EinRainerZufall/ESPHomeCover/Purchase parts/17HS16-2004D_Torque_Curve.pdf

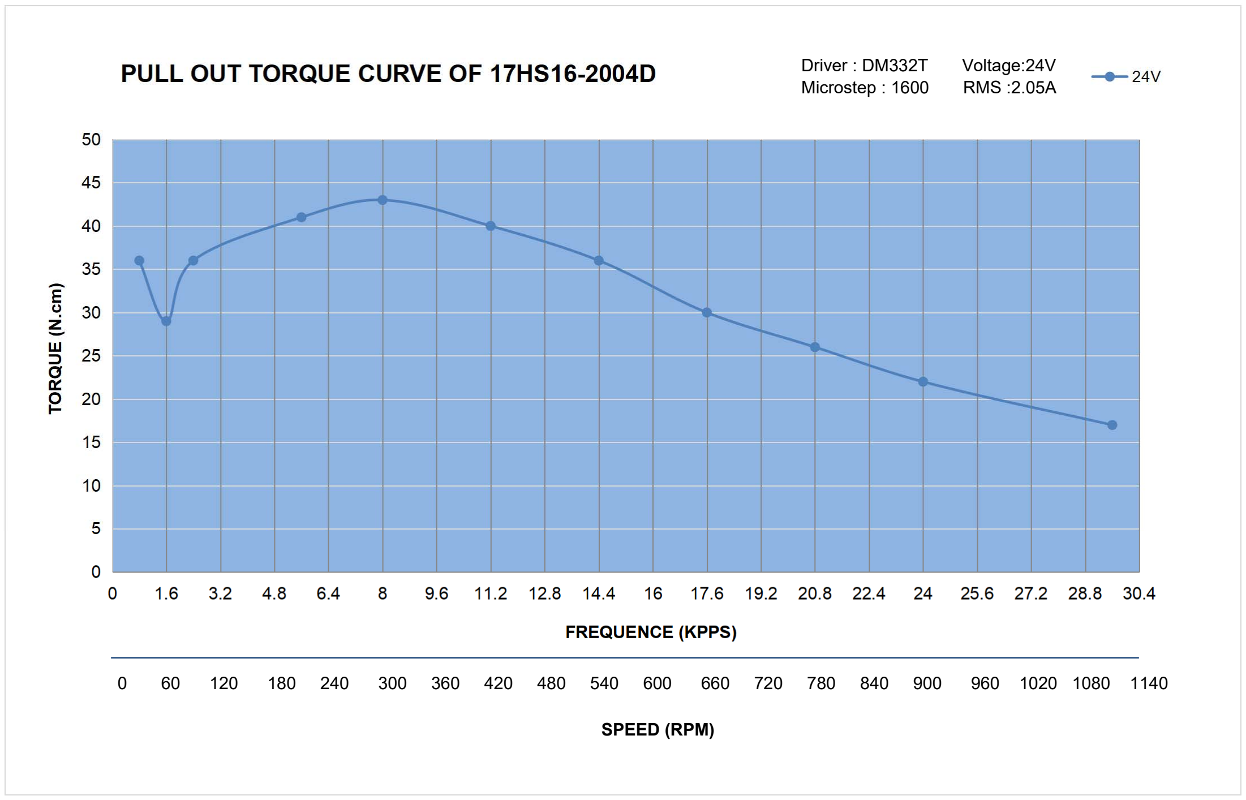
[picture p1: page 1]

Driver : DM332T | Voltage:24V
Microstep : 1600 | RMS :2.05A
0 | 60 | 120 | 180 | 240 | 300 | 360 | 420 | 480 | 540 | 600 | 660 | 720 | 780 | 840 | 900 | 960 1020 1080 1140

SPEED (RPM)
