EinRainerZufall/ESPHomeCover/3D print/complete set.3mf

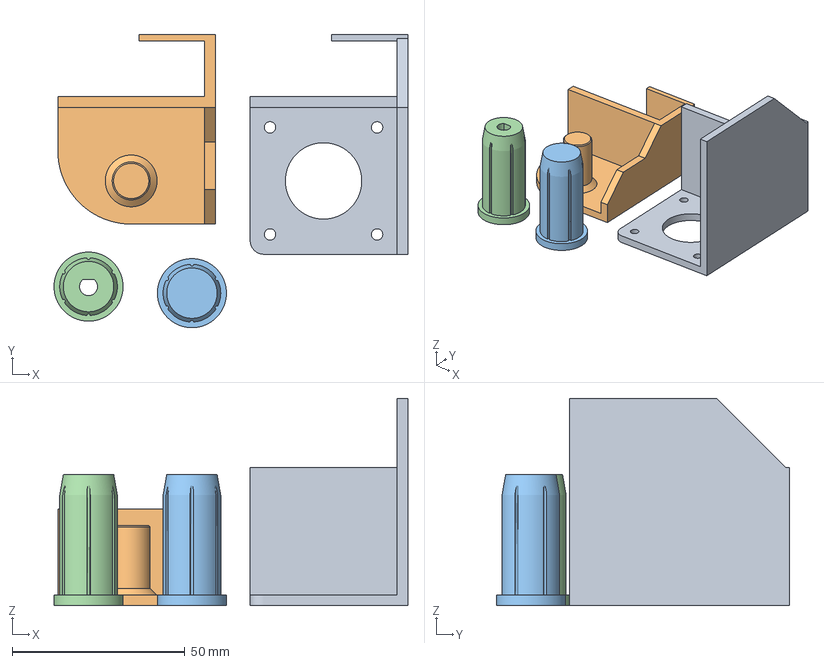
[picture p2: CAD file, 2024-05-02]
3D print/complete set.3mf
102.5 x 84.9 x 60.0 mm
motor holder.stp
counter holder.stp
blind adapter counter side.stp
blind adapter motor side.stp
