EinRainerZufall/ESPHomeCover/3D print/blind adapter counter side.stp

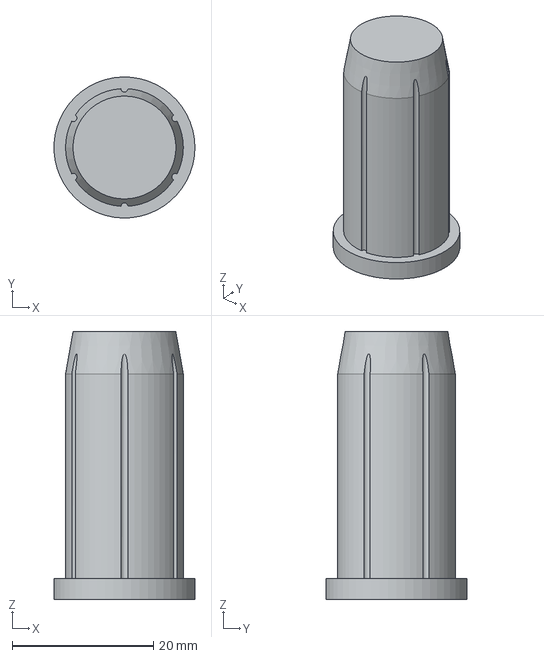
[picture p3: CAD file, 2024-05-02]
3D print/blind adapter counter side.stp
20.0 x 20.0 x 38.0 mm
