EinRainerZufall/ESPHomeCover/Purchase parts/17HS16-2004D.STEP

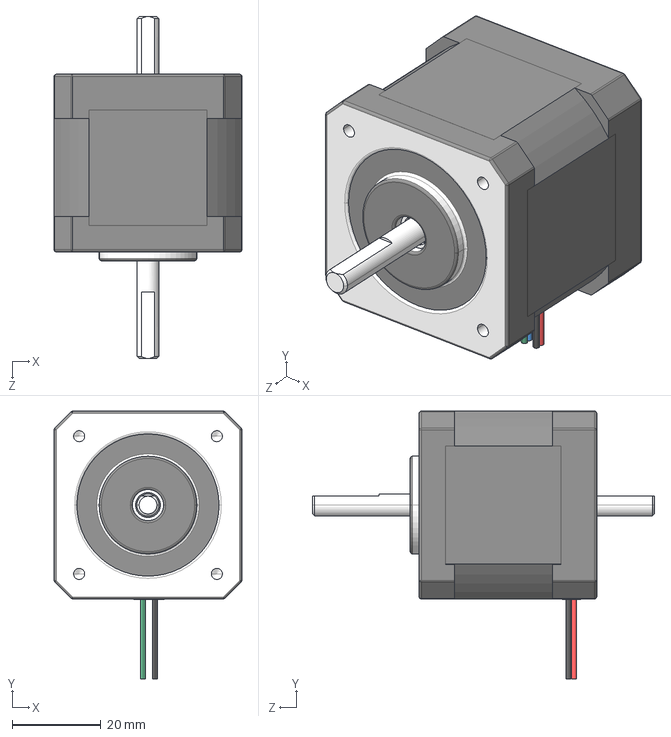
[picture p4: CAD file, 2024-03-02]
Purchase parts/17HS16-2004D.STEP
42.3 x 60.3 x 77.0 mm
