EinRainerZufall/ESPHomeCover/3D print/blind adapter motor side.stp

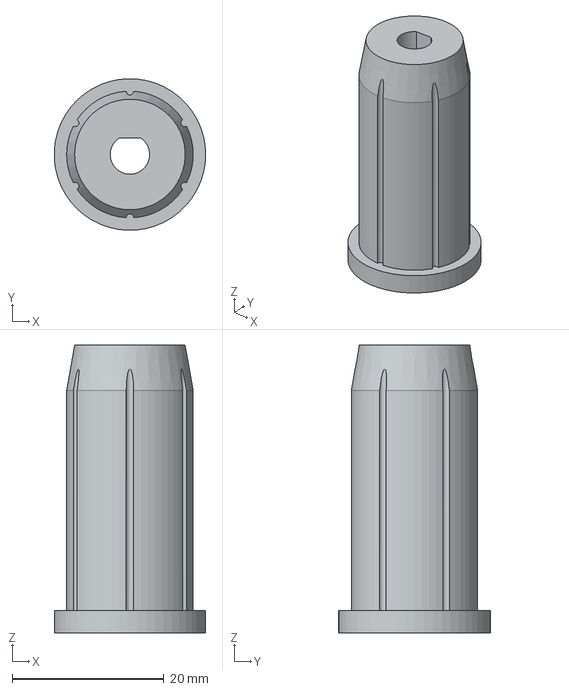
[picture p5: CAD file, 2024-05-02]
3D print/blind adapter motor side.stp
20.0 x 20.0 x 38.0 mm
