EinRainerZufall/ESPHomeCover/Purchase parts/SWB-01.STEP

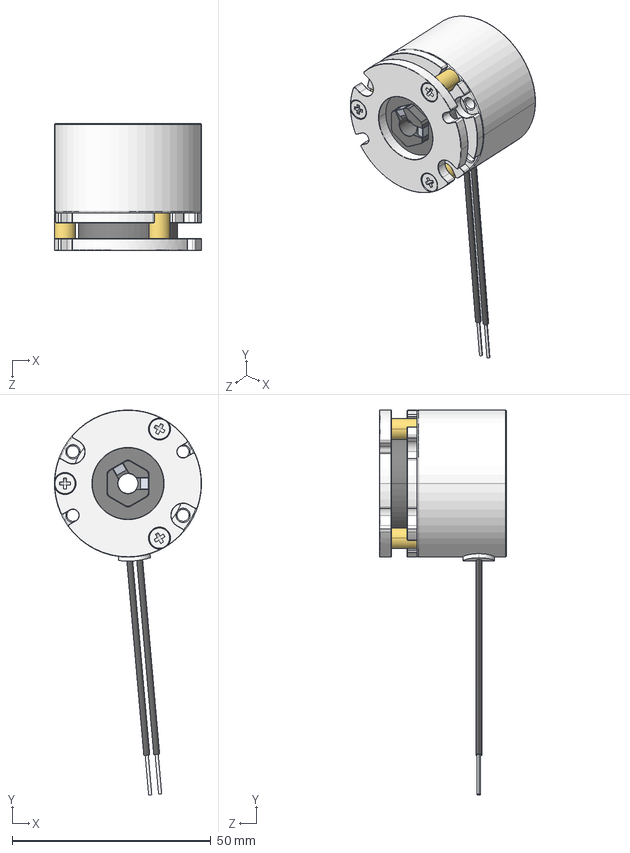
[picture p6: CAD file, 2024-03-02]
Purchase parts/SWB-01.STEP
37.0 x 96.8 x 32.0 mm
