EinRainerZufall/ESPHomeCover/3D print/counter holder.stp

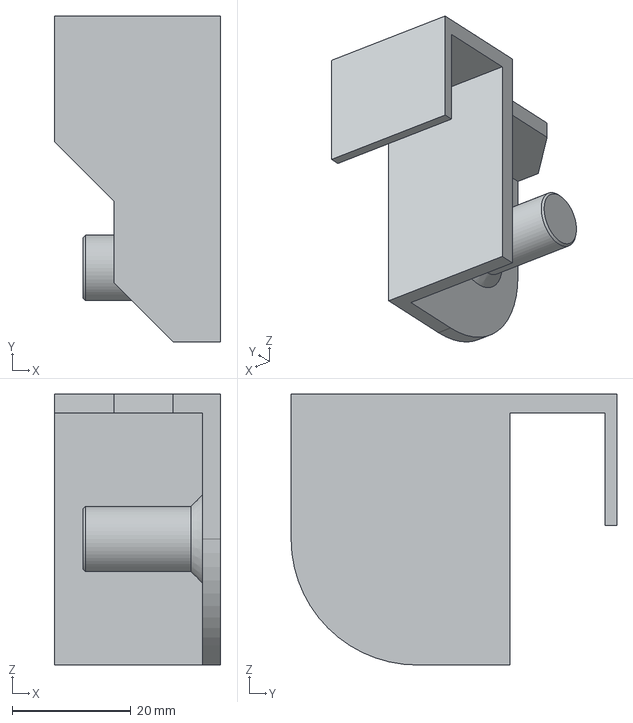
[picture p7: CAD file, 2024-05-02]
3D print/counter holder.stp
28.0 x 55.0 x 45.7 mm
