EinRainerZufall/ESPHomeCover/3D print/motor holder.stp

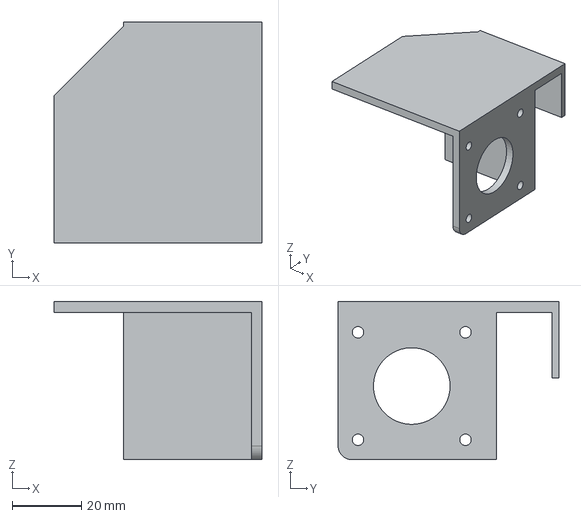
[picture p8: CAD file, 2024-05-02]
3D print/motor holder.stp
60.0 x 63.7 x 45.7 mm
