EinRainerZufall/ESPHomeCover/PCB/ESPHomeCover/ESPHomeCover.kicad_pcb

## KiCad design PCB/ESPHomeCover/ESPHomeCover.kicad_pcb (2024-05-26)

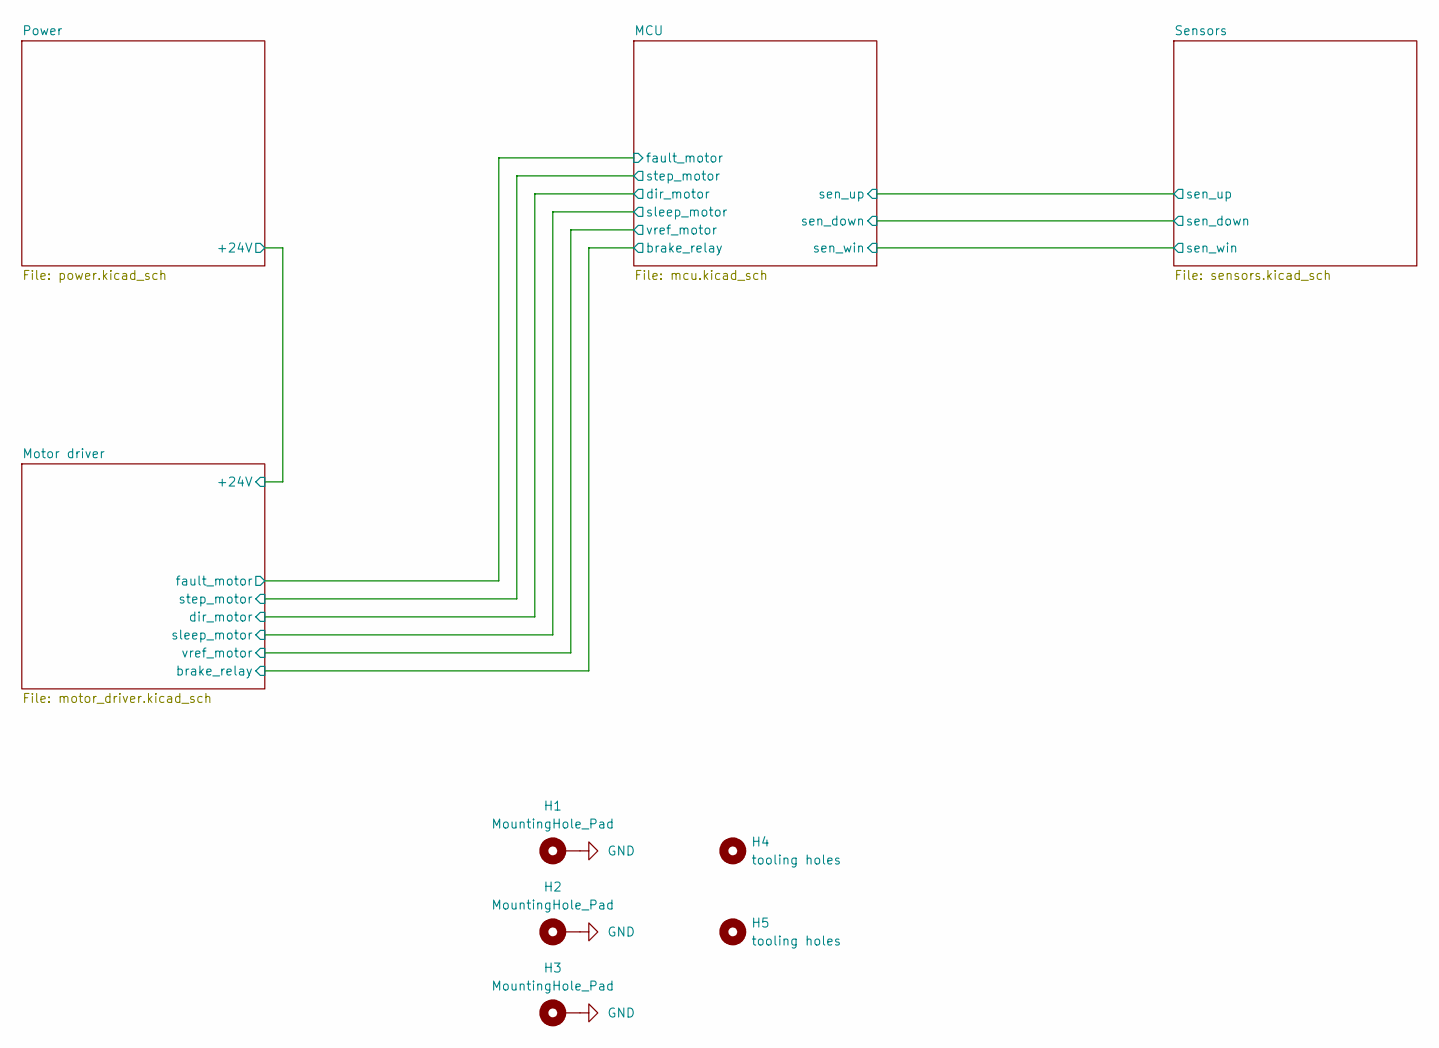
[picture p9: schematic ESPHomeCover.kicad_sch, ESPHome Cover PCB]

Parts:
H1, H2, H3: MountingHole_Pad; MountingHole_3.2mm_M3_ISO14580_Pad
H4, H5: tooling holes

Connections:
GND: H1.1, H2.1, H3.1; also elsewhere on the board

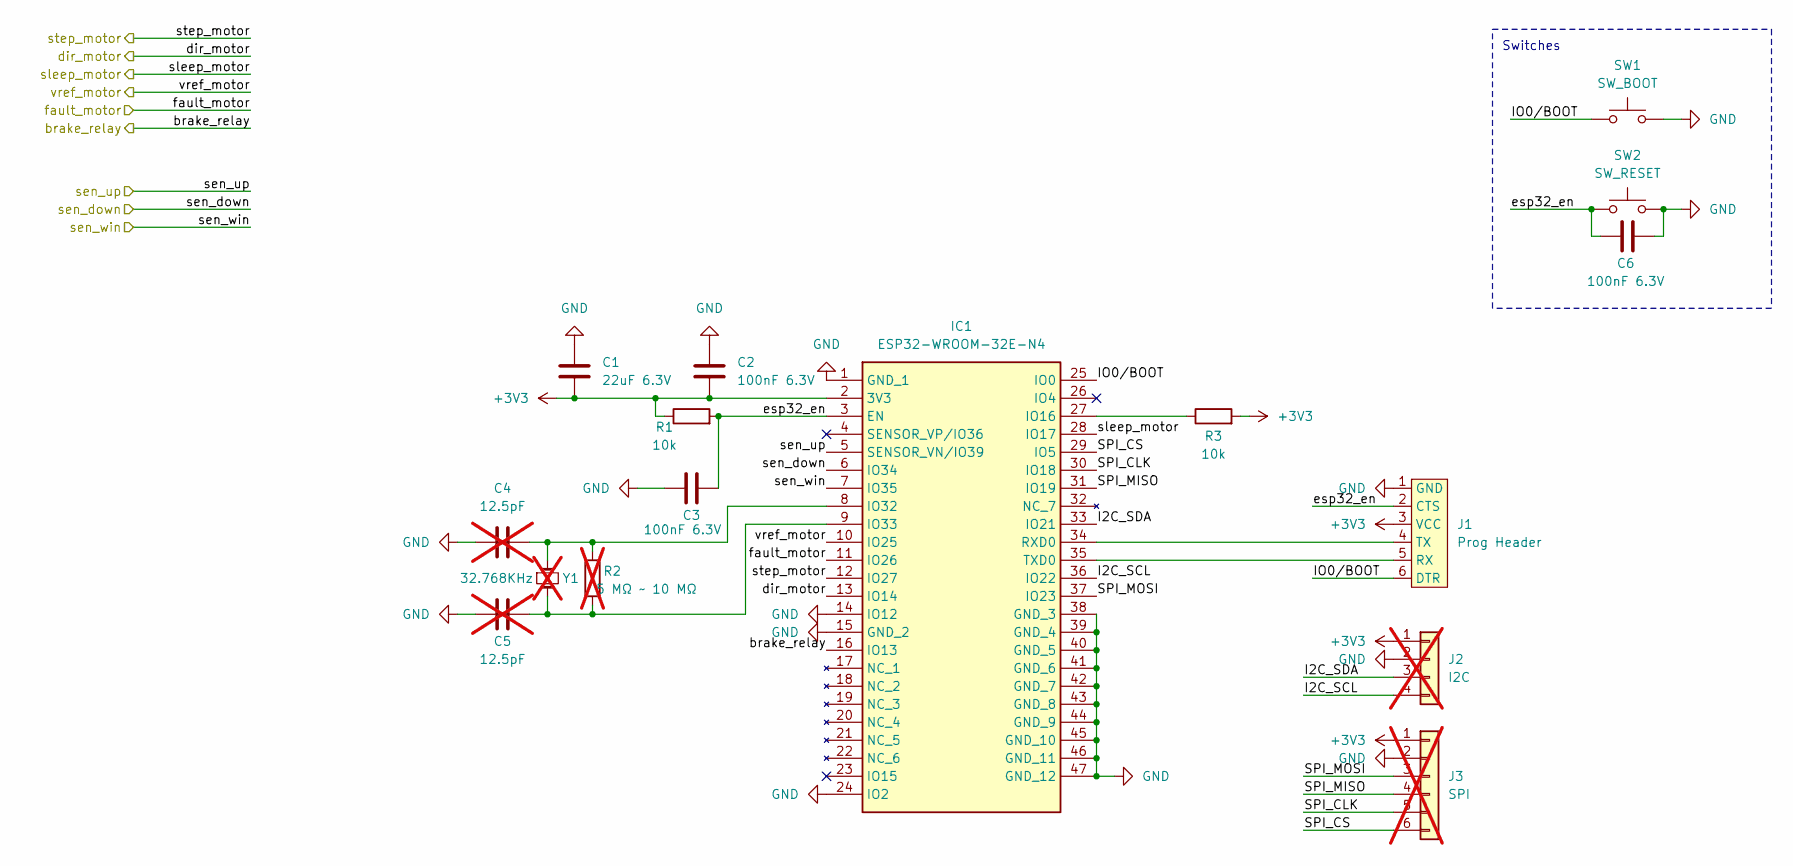
[picture p10: schematic mcu.kicad_sch, ESPHome Cover PCB]

Parts:
C1: 22uF 6.3V; C_0603_1608Metric; Mouser Part Number 963-MSASJ168BB5226MT; LCSC C159801
C2, C3, C6: 100nF 6.3V; C_0603_1608Metric; Mouser Part Number 581-06036C104JAT2A
C4, C5: 12.5pF; C_0603_1608Metric; not fitted
IC1: ESP32-WROOM-32E-N4; ESP32WROOM32EN4; Mouser Part Number 356-ESP32WRM32E132PH
J1: Prog Header
J2: I2C; JST_XH_B4B-XH-A_1x04_P2.50mm_Vertical; not fitted
J3: SPI; JST_XH_B6B-XH-A_1x06_P2.50mm_Vertical; not fitted
R1, R3: 10k; R_0805_2012Metric; Mouser Part Number 667-ERA-6AEB103V; LCSC C17414
R2: 5 MΩ ~ 10 MΩ; R_0805_2012Metric; not fitted
SW1: SW_BOOT; TL3302AF130QG; Mouser Part Number 612-TL3302AF130QG
SW2: SW_RESET; TL3302AF130QG; Mouser Part Number 612-TL3302AF130QG
Y1: 32.768KHz; Crystal_SMD_2012-2Pin_2.0x1.2mm; LCSC C5366544; not fitted

Connections:
+3V3: C1.2, C2.2, IC1.2 (3V3), J1.3 (VCC), J2.1, J3.1, R1.1, R3.2; also elsewhere on the board
/MCU/I2C_SCL: IC1.36 (IO22), J2.4
/MCU/I2C_SDA: IC1.33 (IO21), J2.3
/MCU/IO0/BOOT: IC1.25 (IO0), J1.6 (DTR), SW1.1
/MCU/SPI_CLK: IC1.30 (IO18), J3.5
/MCU/SPI_CS: IC1.29 (IO5), J3.6
/MCU/SPI_MISO: IC1.31 (IO19), J3.4
/MCU/SPI_MOSI: IC1.37 (IO23), J3.3
/MCU/brake_relay: IC1.16 (IO13); also elsewhere on the board
/MCU/dir_motor: IC1.13 (IO14); also elsewhere on the board
/MCU/esp32_en: C3.2, C6.2, IC1.3 (EN), J1.2 (CTS), R1.2, SW2.2
/MCU/fault_motor: IC1.11 (IO26); also elsewhere on the board
/MCU/sen_down: IC1.6 (IO34); also elsewhere on the board
/MCU/sen_up: IC1.5 (SENSOR_VN/IO39); also elsewhere on the board
/MCU/sen_win: IC1.7 (IO35); also elsewhere on the board
/MCU/sleep_motor: IC1.28 (IO17); also elsewhere on the board
/MCU/step_motor: IC1.12 (IO27); also elsewhere on the board
/MCU/vref_motor: IC1.10 (IO25); also elsewhere on the board
GND: C1.1, C2.1, C3.1, C4.1, C5.1, C6.1, IC1.1 (GND_1), IC1.14 (IO12), IC1.15 (GND_2), IC1.24 (IO2), IC1.38 (GND_3), IC1.39 (GND_4), IC1.40 (GND_5), IC1.41 (GND_6), IC1.42 (GND_7), IC1.43 (GND_8), IC1.44 (GND_9), IC1.45 (GND_10), IC1.46 (GND_11), IC1.47 (GND_12), J1.1 (GND), J2.2, J3.2, SW1.2, SW2.1; also elsewhere on the board
unnamed: IC1.27 (IO16), R3.1
unnamed: C4.2, IC1.8 (IO32), R2.2, Y1.1
unnamed: C5.2, IC1.9 (IO33), R2.1, Y1.2
unnamed: IC1.34 (RXD0), J1.4 (TX)
unnamed: IC1.35 (TXD0), J1.5 (RX)

Notes on the sheet:
Switches

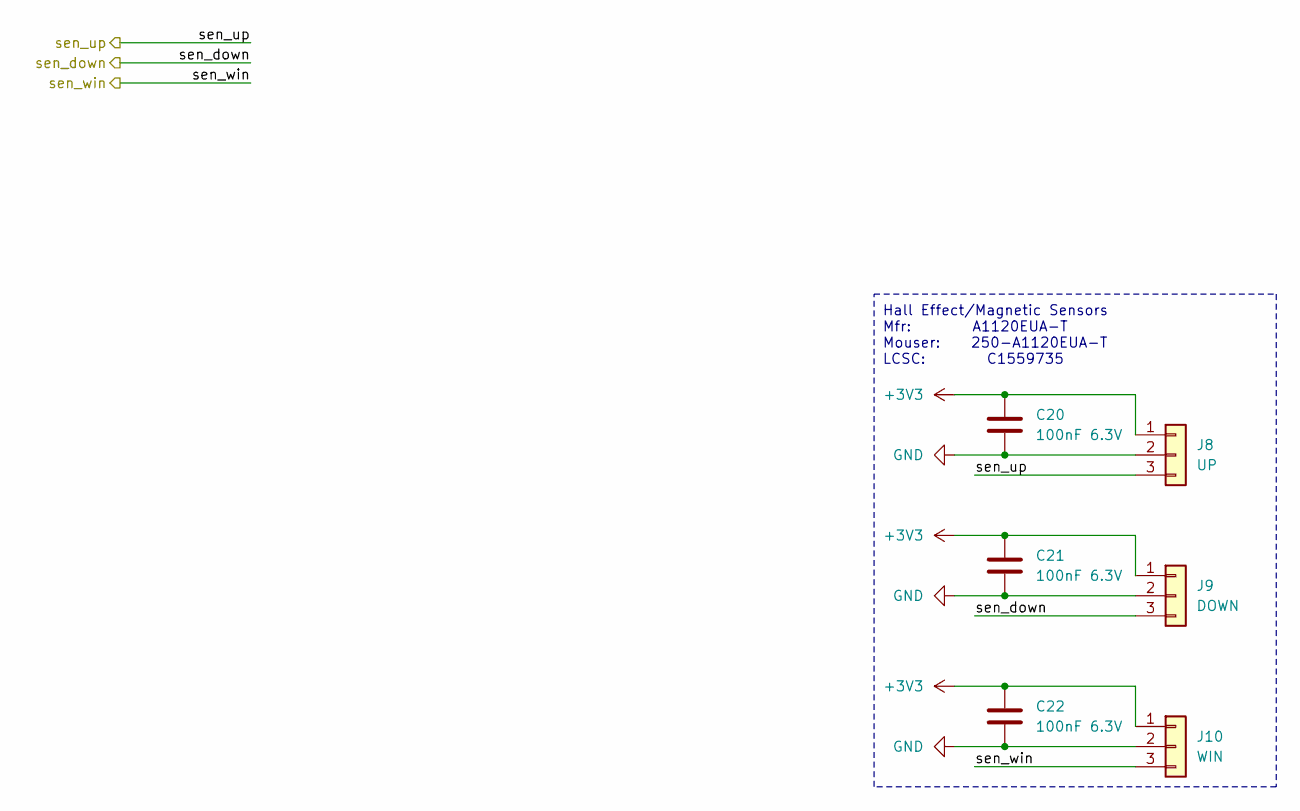
[picture p11: schematic sensors.kicad_sch, ESPHome Cover PCB]

Parts:
C20, C21, C22: 100nF 6.3V; C_0603_1608Metric; Mouser Part Number 581-06036C104JAT2A
J8: UP; JST_XH_B3B-XH-A_1x03_P2.50mm_Vertical
J9: DOWN; JST_XH_B3B-XH-A_1x03_P2.50mm_Vertical
J10: WIN; JST_XH_B3B-XH-A_1x03_P2.50mm_Vertical

Connections:
+3V3: C20.1, C21.1, C22.1, J8.1, J9.1, J10.1; also elsewhere on the board
/MCU/sen_down: J9.3; also elsewhere on the board
/MCU/sen_up: J8.3; also elsewhere on the board
/MCU/sen_win: J10.3; also elsewhere on the board
GND: C20.2, C21.2, C22.2, J8.2, J9.2, J10.2; also elsewhere on the board

Notes on the sheet:
Hall Effect/Magnetic Sensors Mfr: A1120EUA-T Mouser: 250-A1120EUA-T LCSC: C1559735

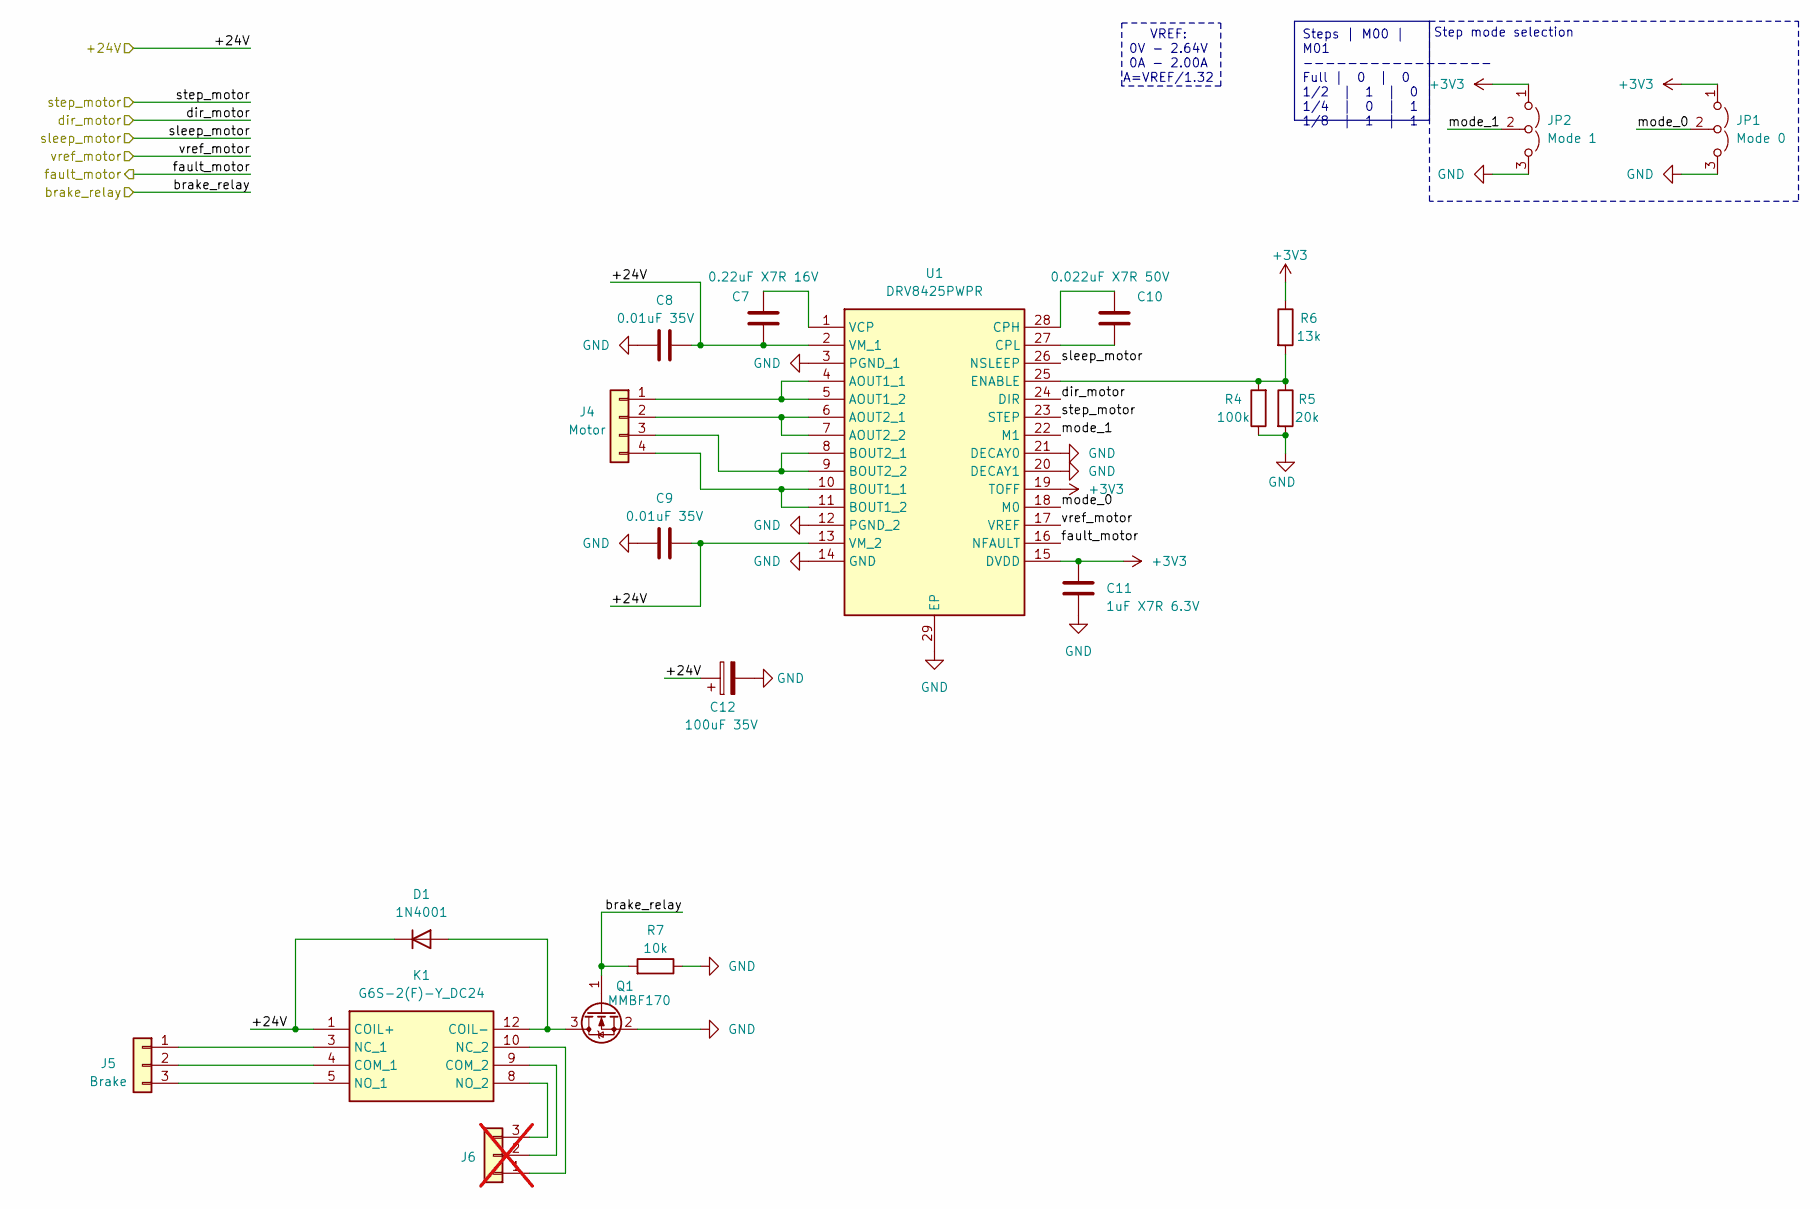
[picture p12: schematic motor_driver.kicad_sch, ESPHome Cover PCB]

Parts:
C7: 0.22uF X7R 16V; C_0603_1608Metric; Mouser Part Number 80-C0603C224K4R
C8, C9: 0.01uF 35V; C_0603_1608Metric; Mouser Part Number 810-C1608C0G1V153JAC
C10: 0.022uF X7R 50V; C_0603_1608Metric; Mouser Part Number 581-06035C223KAT4A; LCSC C77571
C11: 1uF X7R 6.3V; C_0603_1608Metric; Mouser Part Number 581-06035C105KAT2A; LCSC C309479
C12: 100uF 35V; CP_Elec_6.3x7.7; Mouser Part Number 667-EEH-ZK1V101XP; LCSC C72478
D1: 1N4001; D_DO-41_SOD81_P10.16mm_Horizontal; Mouser Part Number 637-1N4001; LCSC C727079
J4: Motor; JST_XH_B4B-XH-A_1x04_P2.50mm_Vertical
J5: Brake; JST_XH_B3B-XH-A_1x03_P2.50mm_Vertical
J6: PinHeader_1x03_P2.54mm_Vertical; not fitted
JP1: Mode 0; PinHeader_1x03_P2.54mm_Vertical_SMD_Pin1Left; LCSC C780061
JP2: Mode 1; PinHeader_1x03_P2.54mm_Vertical_SMD_Pin1Left; LCSC C780061
K1: G6S-2(F)-Y_DC24; G6S2(F)YDC24; Mouser Part Number 653-G6S-2F-YDC241
Q1: MMBF170; SOT-23; Mouser Part Number 512-MMBF170; LCSC C151058
R4: 100k; R_0805_2012Metric; Mouser Part Number 71-CRCW0805100KJNECC; LCSC C149504
R5: 20k; R_0805_2012Metric; Mouser Part Number 71-CRCW080520K0FKEAH; LCSC C4328
R6: 13k; R_0805_2012Metric; Mouser Part Number 71-CRCW080513K0JNEA; LCSC C17455
R7: 10k; R_0805_2012Metric; Mouser Part Number 667-ERA-6AEB103V; LCSC C17414
U1: DRV8425PWPR; SOP65P640X120-29N; Mouser Part Number 595-DRV8425PWPR

Connections:
+3V3: C11.1, JP1.1 (A), JP2.1 (A), R6.1, U1.15 (DVDD), U1.19 (TOFF); also elsewhere on the board
/MCU/brake_relay: Q1.1 (G), R7.2; also elsewhere on the board
/MCU/dir_motor: U1.24 (DIR); also elsewhere on the board
/MCU/fault_motor: U1.16 (NFAULT); also elsewhere on the board
/MCU/sleep_motor: U1.26 (NSLEEP); also elsewhere on the board
/MCU/step_motor: U1.23 (STEP); also elsewhere on the board
/MCU/vref_motor: U1.17 (VREF); also elsewhere on the board
/Motor driver/+24V: C7.2, C8.2, C9.2, C12.1, D1.1 (K), K1.1 (COIL+), U1.2 (VM_1), U1.13 (VM_2); also elsewhere on the board
/Motor driver/mode_0: JP1.2 (C), U1.18 (M0)
/Motor driver/mode_1: JP2.2 (C), U1.22 (M1)
GND: C8.1, C9.1, C11.2, C12.2, JP1.3 (B), JP2.3 (B), Q1.2 (S), R4.1, R5.2, R7.1, U1.3 (PGND_1), U1.12 (PGND_2), U1.14 (GND), U1.20 (DECAY1), U1.21 (DECAY0), U1.29 (EP); also elsewhere on the board
unnamed: D1.2 (A), K1.12 (COIL-), Q1.3 (D)
unnamed: J4.1, U1.4 (AOUT1_1), U1.5 (AOUT1_2)
unnamed: J4.2, U1.6 (AOUT2_1), U1.7 (AOUT2_2)
unnamed: J4.3, U1.8 (BOUT2_1), U1.9 (BOUT2_2)
unnamed: J4.4, U1.10 (BOUT1_1), U1.11 (BOUT1_2)
unnamed: J5.1, K1.3 (NC_1)
unnamed: J5.2, K1.4 (COM_1)
unnamed: J5.3, K1.5 (NO_1)
unnamed: J6.1, K1.10 (NC_2)
unnamed: J6.2, K1.9 (COM_2)
unnamed: J6.3, K1.8 (NO_2)
unnamed: C10.1, U1.28 (CPH)
unnamed: C10.2, U1.27 (CPL)
unnamed: R4.2, R5.1, R6.2, U1.25 (ENABLE)
unnamed: C7.1, U1.1 (VCP)

Notes on the sheet:
Steps | M00 | M01 ----------------- Full | 0 | 0 1/2 | 1 | 0 1/4 | 0 | 1 1/8 | 1 | 1
VREF: 0V - 2.64V 0A - 2.00A A=VREF/1.32
Step mode selection

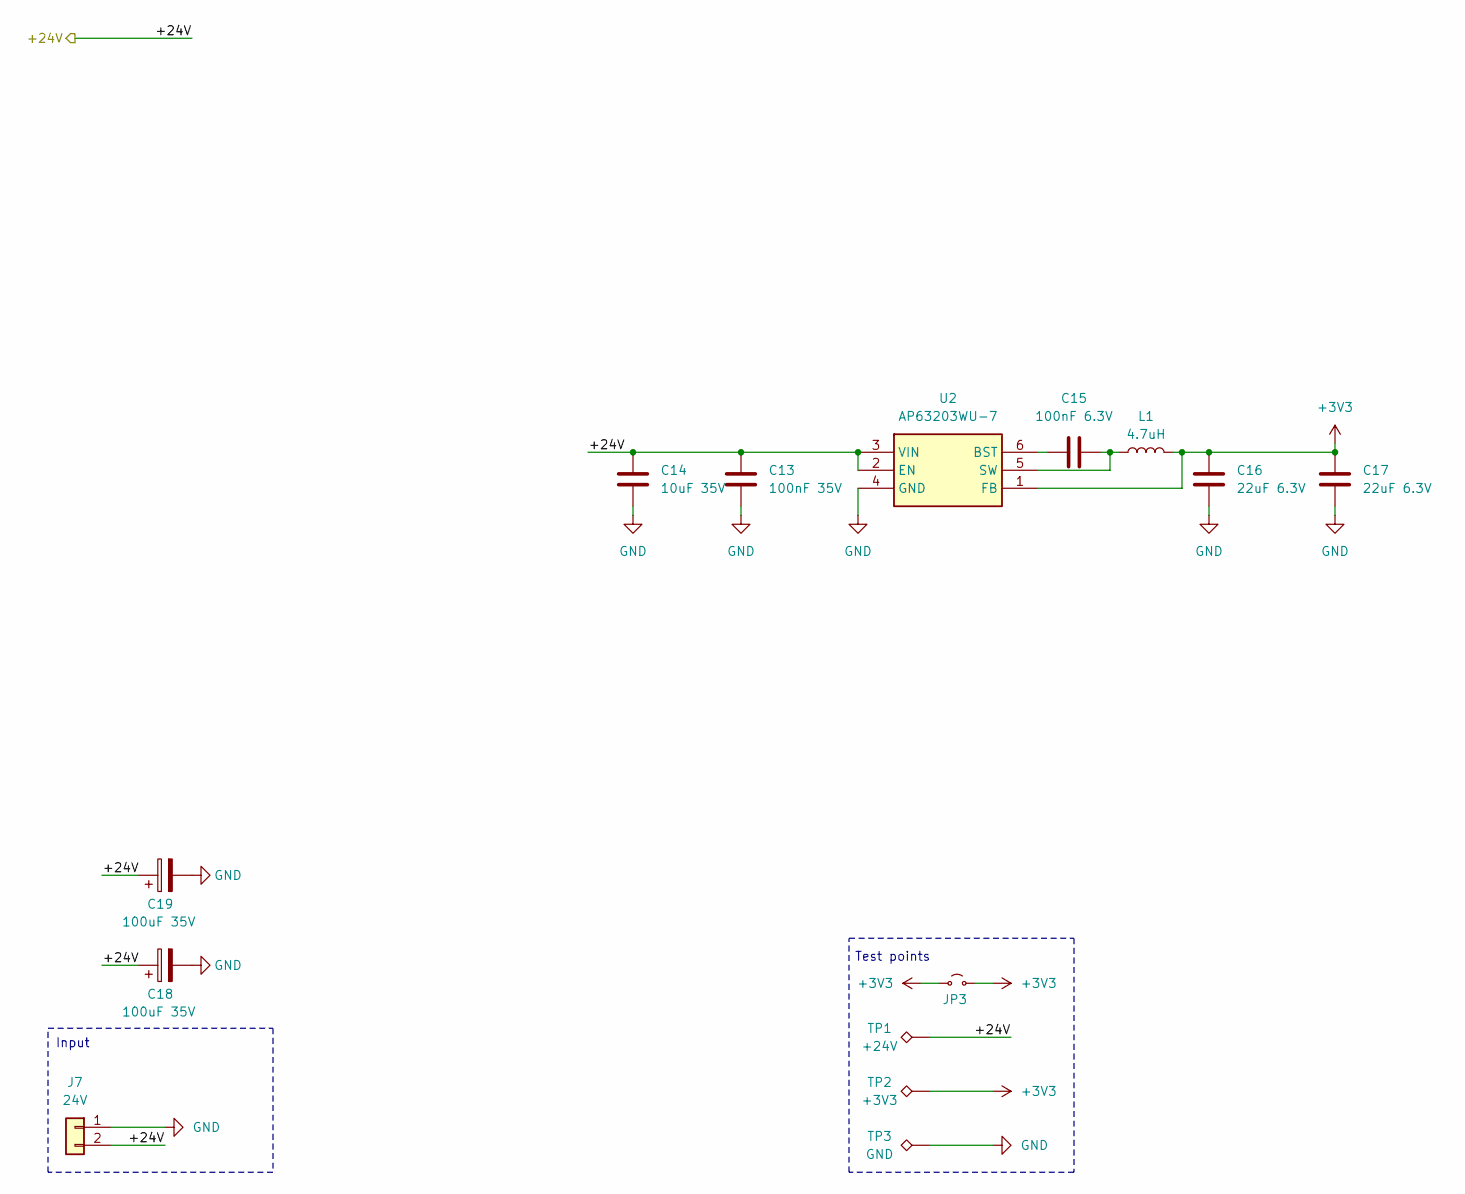
[picture p13: schematic power.kicad_sch, ESPHome Cover PCB]

Parts:
C13: 100nF 35V; C_0603_1608Metric; Mouser Part Number 963-GMK107B7104KAHT; LCSC C385964
C14: 10uF 35V; C_0603_1608Metric; Mouser Part Number 81-GRM188R6YA106MA3J; LCSC C194427
C15: 100nF 6.3V; C_0603_1608Metric; Mouser Part Number 581-06036C104JAT2A
C16, C17: 22uF 6.3V; C_0603_1608Metric; Mouser Part Number 963-MSASJ168BB5226MT; LCSC C159801
C18, C19: 100uF 35V; CP_Elec_6.3x7.7; Mouser Part Number 667-EEH-ZK1V101XP; LCSC C72478
J7: 24V; JST_XH_B2B-XH-A_1x02_P2.50mm_Vertical
JP3: SolderJumper-2_P1.3mm_Open_RoundedPad1.0x1.5mm
L1: 4.7uH; L_1812_4532Metric; Mouser Part Number 871-B82432T1472K; LCSC C394118
TP1: +24V; TestPoint_Pad_1.0x1.0mm
TP2: +3V3; TestPoint_Pad_1.0x1.0mm
TP3: GND; TestPoint_Pad_1.0x1.0mm
U2: AP63203WU-7; TSOT-23-6; Mouser Part Number 621-AP63203WU-7

Connections:
+3V3: C16.1, C17.1, JP3.1 (A), JP3.2 (B), L1.2, TP2.1, U2.1 (FB); also elsewhere on the board
/Motor driver/+24V: C13.1, C14.1, C18.1, C19.1, J7.2, TP1.1, U2.2 (EN), U2.3 (VIN); also elsewhere on the board
GND: C13.2, C14.2, C16.2, C17.2, C18.2, C19.2, J7.1, TP3.1, U2.4 (GND); also elsewhere on the board
unnamed: C15.1, U2.6 (BST)
unnamed: C15.2, L1.1, U2.5 (SW)

Notes on the sheet:
Input
Test points

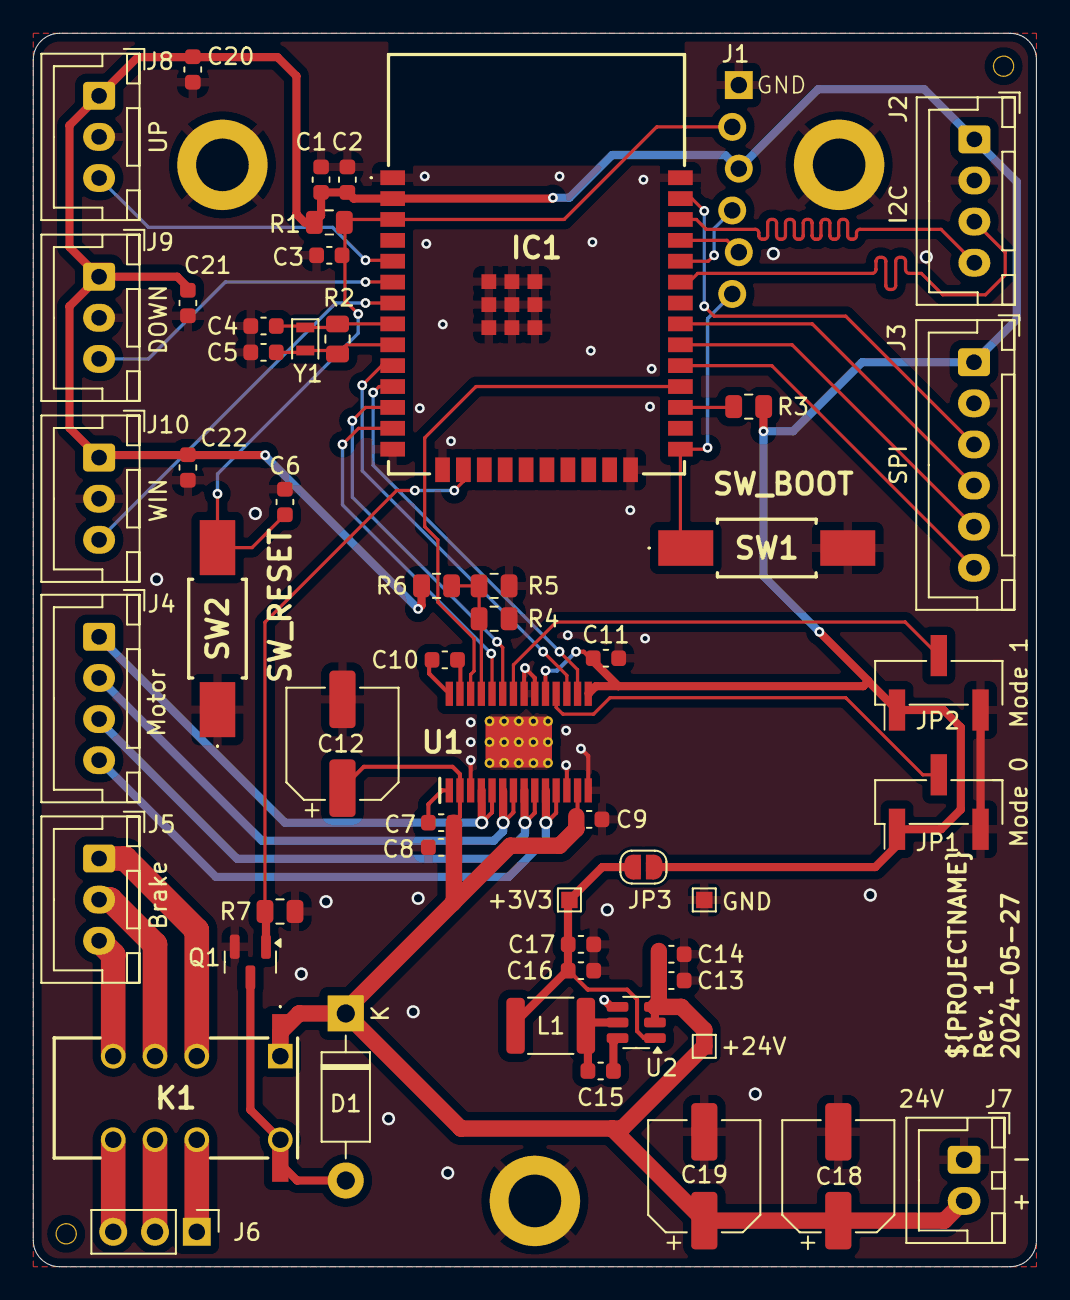
[picture p14: board ESPHomeCover.kicad_pcb from above]

Board: 2 copper layers, 61.0 x 75.0 mm, 60 parts (0 on the bottom side), 44 nets.
