EinRainerZufall/ESPHomeCover/(commit log)

2024-03-02 add purchase parts
    [17HS16-2004D.STEP, SWB-01.STEP]
2024-03-05 update motor holder
    [Assembly.cfg]
2024-05-02 rework of the old models
    [Assembly.cfg, blind adapter counter side.stp, blind adapter motor side.stp, complete set.3mf, counter holder.stp, motor holder.stp]
2024-05-02 improved printability
    [Assembly.cfg, blind adapter counter side.stp, blind adapter motor side.stp, complete set.3mf, counter holder.stp]
2024-05-08 create V1 schematic
    [ESPHomeCover.kicad_pcb, ESPHomeCover.kicad_sch, mcu.kicad_sch, motor_driver.kicad_sch, power.kicad_sch, sensors.kicad_sch]
2024-05-08 Add Board
    [ESPHomeCover.kicad_pcb, ESPHomeCover.kicad_sch, mcu.kicad_sch, motor_driver.kicad_sch, power.kicad_sch, sensors.kicad_sch]
2024-05-12 small changes
    change all Caps to 0603,
    add bom
    [ESPHomeCover.kicad_pcb, ESPHomeCover.kicad_sch, mcu.kicad_sch, motor_driver.kicad_sch, power.kicad_sch, sensors.kicad_sch]
2024-05-26 update PCB
    [ESPHomeCover.kicad_pcb, ESPHomeCover.kicad_sch, mcu.kicad_sch, motor_driver.kicad_sch, power.kicad_sch, sensors.kicad_sch]
2024-05-26 Update bom_ESPHome Cover PCB_v1.html
